wagiminator/ATtiny814-AquaTimer/hardware/AquaTimer_BOM.tsv

ID | Name | Designator | Footprint | Quantity | Manufacturer Part | Manufacturer | Supplier | Supplier Part | Price
1 | CR1220 | B1 | CR1220-SMD | 1
2 | 100n | C1,C5 | C_0603 | 2 | CC0603KRX7R9BB104 | YAGEO | LCSC | C14663 | 0.003
3 | 10u | C2 | C_0603 | 1 | CL10A106MA8NRNC | SAMSUNG | LCSC | C96446 | 0.023
4 | 18p | C3,C4 | C_0603 | 2 | CL10C180JB8NNNC | SAMSUNG | LCSC | C1647 | 0.005
5 | 1u | C6 | C_0603 | 1 | CL10A105KA8NNNC | SAMSUNG | LCSC | C5673 | 0.005
6 | 470uF | C7,C8,C9 | CAP_SMD_10MM | 3 | CS1E471M-CRG10 | SEMTECH | LCSC | C96180 | 0.101
7 | 5817 | D1 | SCHOTTKY_SOD_323 | 1 | 1N5817WS | TWGMC | LCSC | C727114 | 0.031
8 | INPUT | DC1 | CONN-TH_DC-005-2.5A-2.0 | 1 | DC-005-2.5A-2.0 | XKB Enterprise | LCSC | C319099 | 0.076
9 | 5A | F1 | F_1206 | 1 | 12H1500D | Shenzhen lanson Elec | LCSC | C182446 | 0.041
10 | OUT1 | H1 | KF301-2P | 1 | KF301-5.0-2P | Cixi Kefa Elec | LCSC | C474881 | 0.083
11 | OUT2 | H2 | KF301-2P | 1 | KF301-5.0-2P | Cixi Kefa Elec | LCSC | C474881 | 0.083
12 | OUT3 | H3 | KF301-2P | 1 | KF301-5.0-2P | Cixi Kefa Elec | LCSC | C474881 | 0.083
13 | UPDI | H4 | 210S-3X1/2.54 | 1 | Header2.54mm 1*3P | BOOMELE | LCSC | C49257 | 0.013
14 | OLED | H5 | I2C OLED 0.96 NEW | 1 | SSD1306 I2C OLED
15 | UP | KEY1 | KEY-6.0*6.0 | 1 | SMD Tactile Switch6*6*6mm | ReliaPro | LCSC | C23873 | 0.018
16 | DOWN | KEY2 | KEY-6.0*6.0 | 1 | SMD Tactile Switch6*6*6mm | ReliaPro | LCSC | C23873 | 0.018
17 | SET | KEY3 | KEY-6.0*6.0 | 1 | SMD Tactile Switch6*6*6mm | ReliaPro | LCSC | C23873 | 0.018
18 | OUT1 | LED1 | LED_0603 | 1 | KT-0603R | KENTO | LCSC | C2286
19 | OUT2 | LED2 | LED_0603 | 1 | KT-0603R | KENTO | LCSC | C2286
20 | OUT3 | LED3 | LED_0603 | 1 | KT-0603R | KENTO | LCSC | C2286
21 | AO3401A | Q1,Q3,Q5 | SOT-23-3_W | 3 | AO3401A | HUASHUO(华朔) | LCSC | C700954 | 0.036
22 | 3904 | Q2,Q4,Q6 | SOT-23-3_W | 3 | MMBT3904 | CJ | LCSC | C20526 | 0.013
23 | DMP1045U-7 | Q7 | SOT-23-3_W | 1 | DMP1045U-7 | Diodes Incorporated | LCSC | C177033 | 0.508
24 | 10k | R1,R4,R7,R10 | 0603 | 4 | 0603WAF1002T5E | UniOhm | LCSC | C25804 | 0.001
25 | 1k | R2,R5,R8 | 0603 | 3 | 0603WAF1001T5E | UniOhm | LCSC | C21190 | 0.001
26 | 4k7 | R3,R6,R9 | 0603 | 3 | 0603WAF4701T5E | UniOhm | LCSC | C23162 | 0.001
27 | ATTINY814-SSN | U1 | SOIC-14_150MIL | 1 | ATTINY814-SSNR | Microchip Tech | LCSC | C182202 | 1.361
28 | 78L05 | U2 | SOT-89-3 | 1 | 78L05 | LGE | LCSC | C402226 | 0.059
29 | 32.768KHz | X1 | OSC-SMD_3215 | 1 | AH03270014 | TXC Corp | LCSC | C409356
