wagiminator/ATtiny814-AquaTimer/hardware/AquaTimer_schematic.pdf

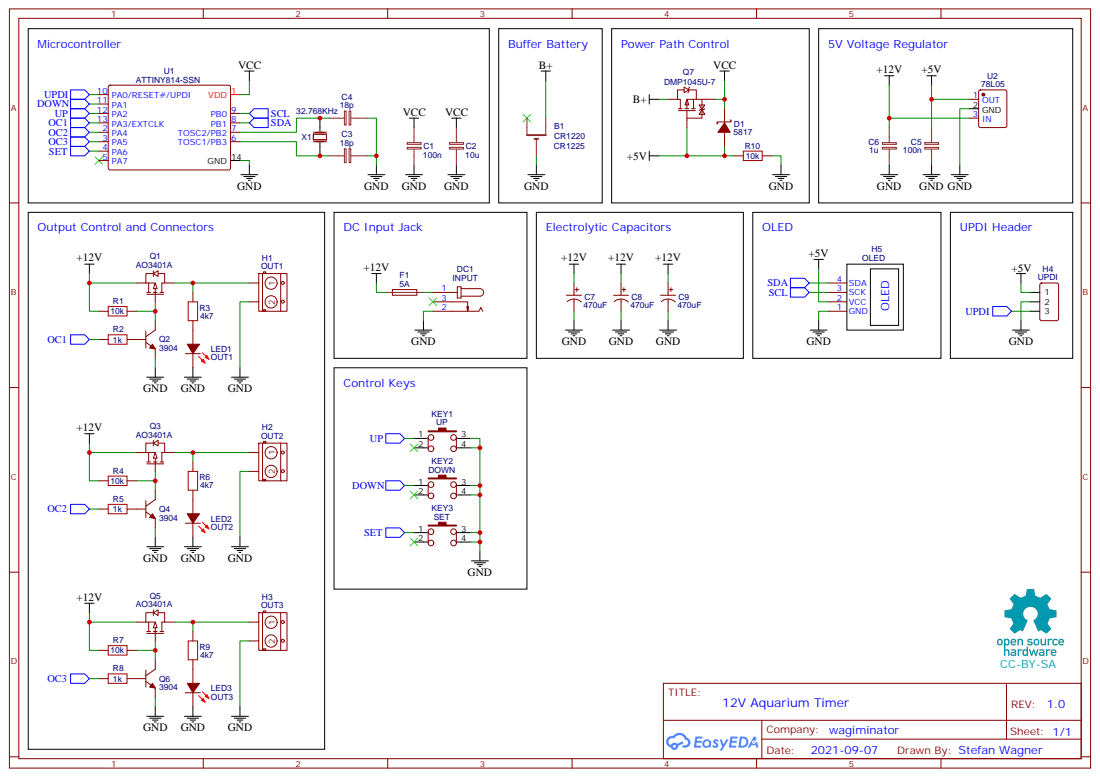
[picture p5: page 1]

Drawn By: Stefan Wagner
